65roadster/lab-supply/Design-Doc.xlsx

Buck/Boost Stage Efficiency
efficiency | 90%
Fsw | 500000 |  |  |  |  |  |  |  | Efficiency vs Vout |  |  |  |  |  |  |  |  |  |  |  |  | Max Iout vs Vout |  |  |  |  |  |  |  |  |  |  |  |  |  | Max Iout vs Vout, limited to 0.5A |  |  |  |  |  |  |  |  |  |  |  |  |  | Max Iout vs Vout, no LDO
L | 2.2e-05 |  |  |  |  |  |  |  | Vout | Vin,linear | Vin | Iout,linear | Iout,bb | Iin,bb | Pin | Pout,bb | Pout,linear | Pdiss,linear | Pdiss,bb | Total Pdiss | Total Eff | Vout | Vin,linear | Vin | Iout,linear | Iout,bb | Iin,bb | Pin | Pout,bb | Pout,linear | Pdiss,linear | Pdiss,bb | Total Pdiss | Total Eff | Pload | Vout | Vin,linear | Vin | Iout,linear | Iout,bb | Iin,bb | Pin | Pout,bb | Pout,linear | Pdiss,linear | Pdiss,bb | Total Pdiss | Total Eff | Pload | Vout | Vin,linear | Vin | Iout,bb
 |  |  |  |  |  |  |  |  | 0 | 1.5 | 5 | 0.5 | 0.5 | 0.17 | 0.8333333333 | 0.75 | 0 | 0.75 | 0.08333333333 | 0.8333333333 | 0% | 0 | 1.5 | 5 | 3 | 3 | 1.00 | 5 | 4.5 | 0 | 4.5 | 0.5 | 5 | 0% | 0 | 0 | 1.5 | 5 | 1.5 | 1.5 | 1.00 | 5 | 2.25 | 0 | 2.25 | 0.25 | 2.5 | 0% | 0 | 0.001 | 0.001 | 5 | 1.5
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
