65roadster/lab-supply/lab-supply-control-board.kicad_pcb

## KiCad design lab-supply-control-board.kicad_pcb (2020-06-25)

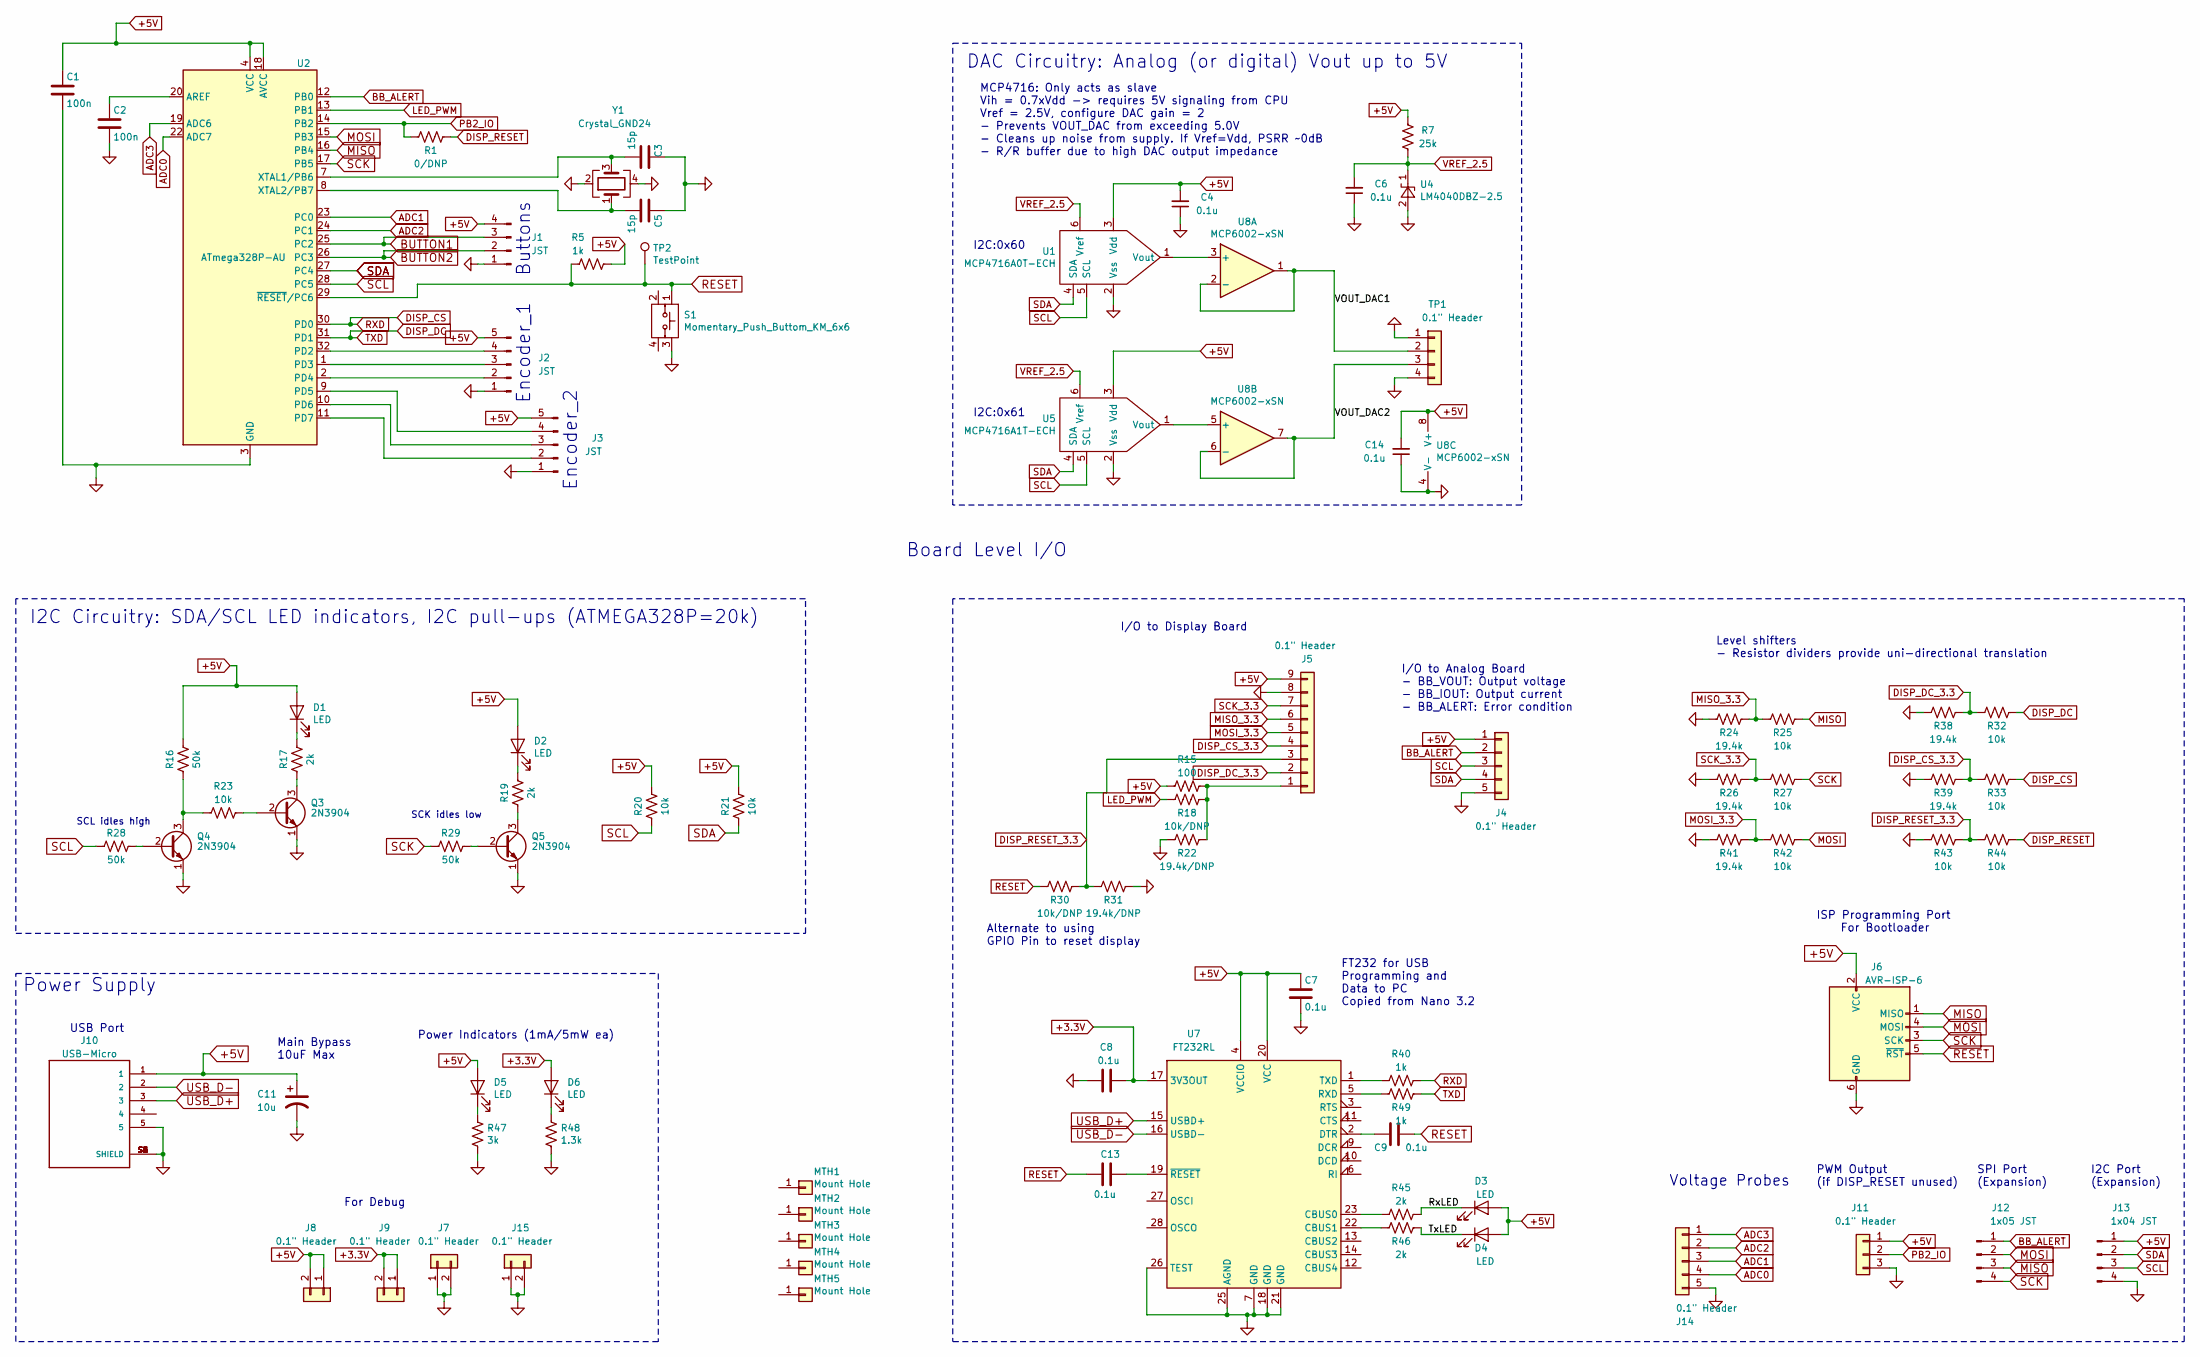
[picture p3: schematic lab-supply-control-board.sch]

Parts:
C1, C2: 100n; C_0805_HandSoldering
C3, C5: 15p; C_0603_HandSoldering
C4, C6, C7, C8, C9, C13, C14: 0.1u; C_0805_HandSoldering
C11: 10u; CP_Elec_4x4.5
D1, D2, D3, D4, D5, D6: LED; LED_0805_2012Metric_Pad1.15x1.40mm_HandSolder
J1: JST; JST_XH_B4B-XH-A_1x04_P2.50mm_Vertical
J2, J3: JST; JST_XH_B5B-XH-A_1x05_P2.50mm_Vertical
J4, J14: 0.1\" Header; JST_XH_B5B-XH-A_1x05_P2.50mm_Vertical
J5: 0.1\" Header; JST_XH_B9B-XH-A_1x09_P2.50mm_Vertical
J6: AVR-ISP-6; AVR-ISP-6-TH
J7, J8, J9, J15: 0.1\" Header; PinHeader_1x02_P2.54mm_Vertical
J10: USB-Micro; USB-Micro-AMPHENOL_10118194-0001LF
J11: 0.1\" Header; PinHeader_1x03_P2.54mm_Vertical
J12: 1x05 JST; JST_XH_B4B-XH-A_1x04_P2.50mm_Vertical
J13: 1x04 JST; JST_XH_B4B-XH-A_1x04_P2.50mm_Vertical
MTH1, MTH2, MTH3, MTH4, MTH5: Mount Hole; Mount-Hole-#6
Q3, Q4, Q5: 2N3904; 2N3904-SOT-23
R1: 0/DNP; R_0805_HandSoldering
R5, R40, R49: 1k; R_0805_HandSoldering
R7: 25k; R_0805_HandSoldering
R15: 100; R_0805_HandSoldering
R16, R28, R29: 50k; R_0805_HandSoldering
R17, R19, R45, R46: 2k; R_0805_HandSoldering
R18, R30: 10k/DNP; R_0805_HandSoldering
R20, R21, R23, R25, R27, R32, R33, R42, R43, R44: 10k; R_0805_HandSoldering
R22, R31: 19.4k/DNP; R_0805_HandSoldering
R24, R26, R38, R39, R41: 19.4k; R_0805_HandSoldering
R47: 3k; R_0805_HandSoldering
R48: 1.3k; R_0805_HandSoldering
S1: Momentary_Push_Buttom_KM_6x6; Momentary_Push_Button_KM_6x6
TP1: 0.1\" Header; JST_XH_B4B-XH-A_1x04_P2.50mm_Vertical
TP2: TestPoint; PinHeader_1x01_P2.54mm_Vertical
U1: MCP4716A0T-ECH; SOT-23-6_Handsoldering
U2: ATmega328P-AU; TQFP-32_7x7mm_P0.8mm
U4: LM4040DBZ-2.5; SOT-23
U5: MCP4716A1T-ECH; SOT-23-6_Handsoldering
U7: FT232RL; SSOP-28_5.3x10.2mm_P0.65mm
U8: MCP6002-xSN; SOP-8_3.9x4.9mm_P1.27mm
Y1: Crystal_GND24; Crystal_SMD_CX2016DB_2.0x1.6mm

Connections:
+3.3V: C8.2, D6.2 (A), J9.1, J9.2, U7.17 (3V3OUT)
+5V: C1.1, C4.2, C7.1, C11.1, C14.2, D1.2 (A), D2.2 (A), D3.2 (A), D4.2 (A), D5.2 (A), J1.4, J2.5, J3.5, J4.1, J5.9, J6.2 (VCC), J8.1, J8.2, J10.1, J11.1, J13.1, R5.2, R7.2, R15.1, R16.1, R20.2, R21.2, U1.3 (Vdd), U2.4 (VCC), U2.6 (VCC), U2.18 (AVCC), U5.3 (Vdd), U7.4 (VCCIO), U7.20 (VCC), U8.8 (V+)
/RxLED: D3.1 (K), R45.1
/TxLED: D4.1 (K), R46.1
/VOUT_DAC1: TP1.2, U8.1, U8.2 (-)
/VOUT_DAC2: TP1.3, U8.6 (-), U8.7
ADC0: J14.4, U2.22 (ADC7)
ADC1: J14.3, U2.23 (PC0)
ADC2: J14.2, U2.24 (PC1)
ADC3: J14.1, U2.19 (ADC6)
BB_ALERT: J4.2, J12.1, U2.12 (PB0)
BUTTON1: J1.3, U2.25 (PC2)
BUTTON2: J1.2, U2.26 (PC3)
DISP_CS: R33.2, R40.1, U2.30 (PD0)
DISP_CS_3.3: J5.4, R33.1, R39.2
DISP_DC: R32.2, R49.1, U2.31 (PD1)
DISP_DC_3.3: J5.2, R32.1, R38.2
DISP_RESET: R1.2, R44.2
DISP_RESET_3.3: J5.3, R30.2, R31.1, R43.2, R44.1
GND: C1.2, C2.2, C3.1, C4.1, C5.1, C6.1, C7.2, C8.1, C11.2, C14.1, J1.1, J2.1, J3.1, J4.5, J5.8, J6.6 (GND), J7.1, J7.2, J10.5, J10.S1 (SHIELD), J10.S2 (SHIELD), J10.S3 (SHIELD), J10.S4 (SHIELD), J10.S5 (SHIELD), J10.S6 (SHIELD), J11.3, J13.4, J14.5, J15.1, J15.2, Q3.1 (E), Q4.1 (E), Q5.1 (E), R22.1, R24.1, R26.1, R31.2, R38.1, R39.1, R41.1, R43.1, R47.2, R48.2, S1.3, TP1.1, TP1.4, U1.2 (Vss), U2.3 (GND), U2.5 (GND), U2.21 (GND), U4.2 (A), U5.2 (Vss), U7.7 (GND), U7.18 (GND), U7.21 (GND), U7.25 (AGND), U7.26 (TEST), U8.4 (V-), Y1.2, Y1.4
LED_PWM: R18.1, U2.13 (PB1)
MISO: J6.1 (MISO), J12.3, R25.2, U2.16 (PB4)
MISO_3.3: J5.6, R24.2, R25.1
MOSI: J6.4 (MOSI), J12.2, R42.2, U2.15 (PB3)
MOSI_3.3: J5.5, R41.2, R42.1
unnamed: C2.1, U2.20 (AREF)
unnamed: C3.2, U2.7 (XTAL1/PB6), Y1.3
unnamed: C5.2, U2.8 (XTAL2/PB7), Y1.1
unnamed: C9.1, U7.2 (DTR)
unnamed: C13.1, U7.19 (~RESET~)
unnamed: D1.1 (K), R17.2
unnamed: D2.1 (K), R19.2
unnamed: D5.1 (K), R47.1
unnamed: D6.1 (K), R48.1
unnamed: J2.2, U2.2 (PD4)
unnamed: J2.3, U2.1 (PD3)
unnamed: J2.4, U2.32 (PD2)
unnamed: J3.2, U2.11 (PD7)
unnamed: J3.3, U2.10 (PD6)
unnamed: J3.4, U2.9 (PD5)
unnamed: J5.1, R15.2, R18.2, R22.2
unnamed: Q3.2 (B), R23.2
unnamed: Q3.3 (C), R17.1
unnamed: Q4.2 (B), R28.2
unnamed: Q4.3 (C), R16.2, R23.1
unnamed: Q5.2 (B), R29.2
unnamed: Q5.3 (C), R19.1
unnamed: R40.2, U7.1 (TXD)
unnamed: R45.2, U7.23 (CBUS0)
unnamed: R46.2, U7.22 (CBUS1)
unnamed: R49.2, U7.5 (RXD)
unnamed: U1.1 (Vout), U8.3 (+)
unnamed: U5.1 (Vout), U8.5 (+)
PB2_IO: J11.2, R1.1, U2.14 (PB2)
RESET: C9.2, C13.2, J6.5 (~RST), R5.1, R30.1, S1.1, TP2.1, U2.29 (~RESET~/PC6)
SCK: J6.3 (SCK), J12.4, R27.2, R29.1, U2.17 (PB5)
SCK_3.3: J5.7, R26.2, R27.1
SCL: J4.3, J13.3, R20.1, R28.1, U1.5 (SCL), U2.28 (PC5), U5.5 (SCL)
SDA: J4.4, J13.2, R21.1, U1.4 (SDA), U2.27 (PC4), U5.4 (SDA)
USB_D+: J10.3, U7.15 (USBD+)
USB_D-: J10.2, U7.16 (USBD-)
VREF_2.5: C6.2, R7.1, U1.6 (Vref), U4.1 (K), U5.6 (Vref)

Notes on the sheet:
Voltage Probes
Encoder_1
Encoder_2
SCL idles high
SCK idles low
ISP Programming Port For Bootloader
DAC Circuitry: Analog (or digital) Vout up to 5V
SPI Port (Expansion)
I2C Circuitry: SDA/SCL LED indicators, I2C pull-ups (ATMEGA328P=20k)
USB Port
Board Level I/O
I2C Port (Expansion)
I/O to Display Board
MCP4716: Only acts as slave Vih = 0.7xVdd -> requires 5V signaling from CPU Vref = 2.5V, configure DAC gain = 2 - Prevents VOUT_DAC from exceeding 5.0V - Cleans up noise from supply. If Vref=Vdd, PSRR ~~0dB - R/R buffer due to high DAC output impedance
Power Indicators (1mA/5mW ea)
For Debug
PWM Output (if DISP_RESET unused)
I/O to Analog Board - BB_VOUT: Output voltage - BB_IOUT: Output current - BB_ALERT: Error condition
Level shifters - Resistor dividers provide uni-directional translation
Power Supply
Alternate to using GPIO Pin to reset display
Main Bypass 10uF Max
FT232 for USB Programming and Data to PC Copied from Nano 3.2
I2C:0x60
I2C:0x61
Buttons

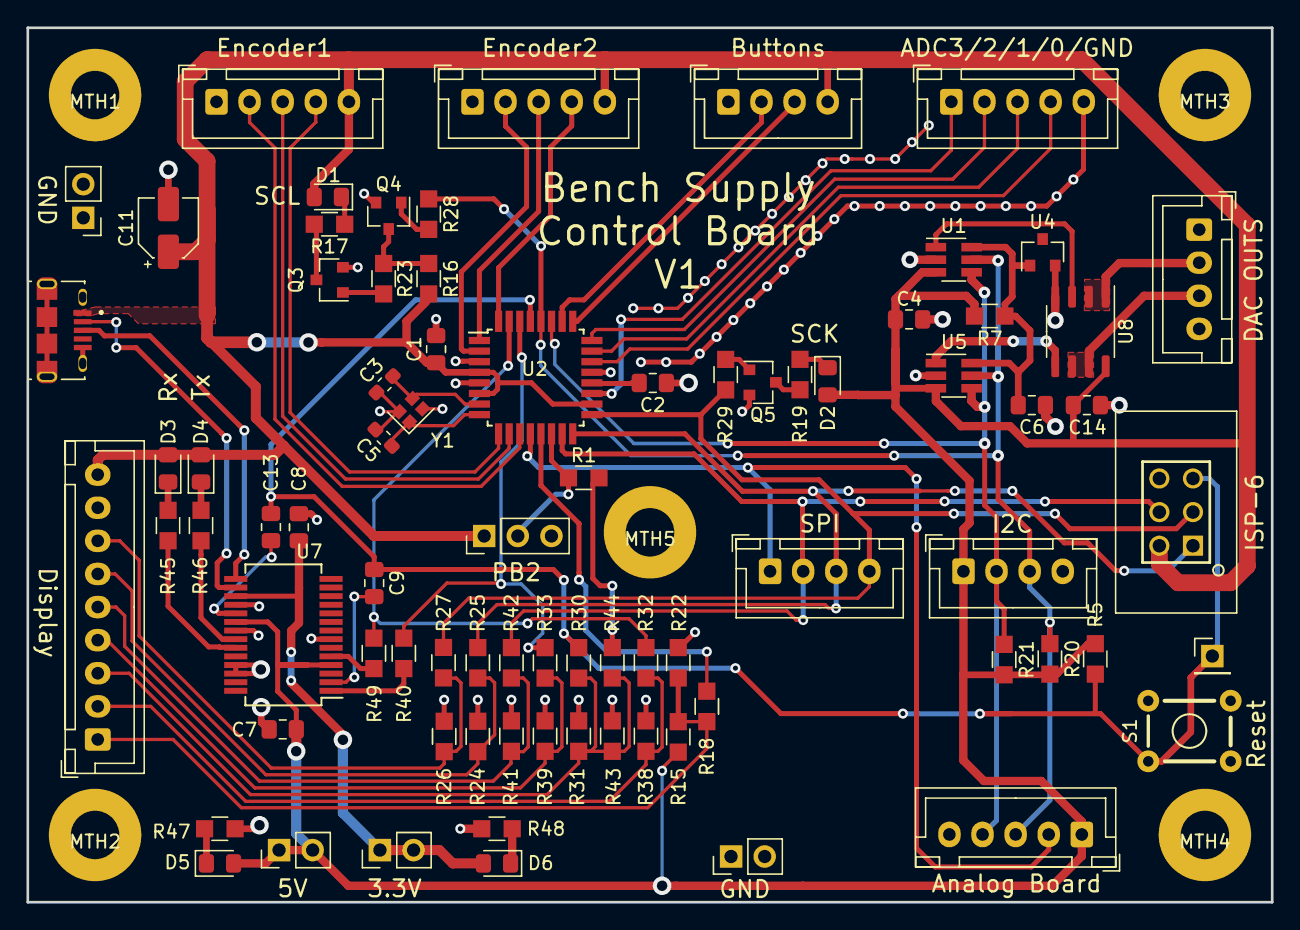
[picture p4: board lab-supply-control-board.kicad_pcb from above]

Board: 2 copper layers, 94.0 x 66.0 mm, 85 parts (0 on the bottom side), 62 nets.
