65roadster/lab-supply/lab-supply-split-rail.kicad_pcb

## KiCad design lab-supply-split-rail.kicad_pcb (2020-06-10)

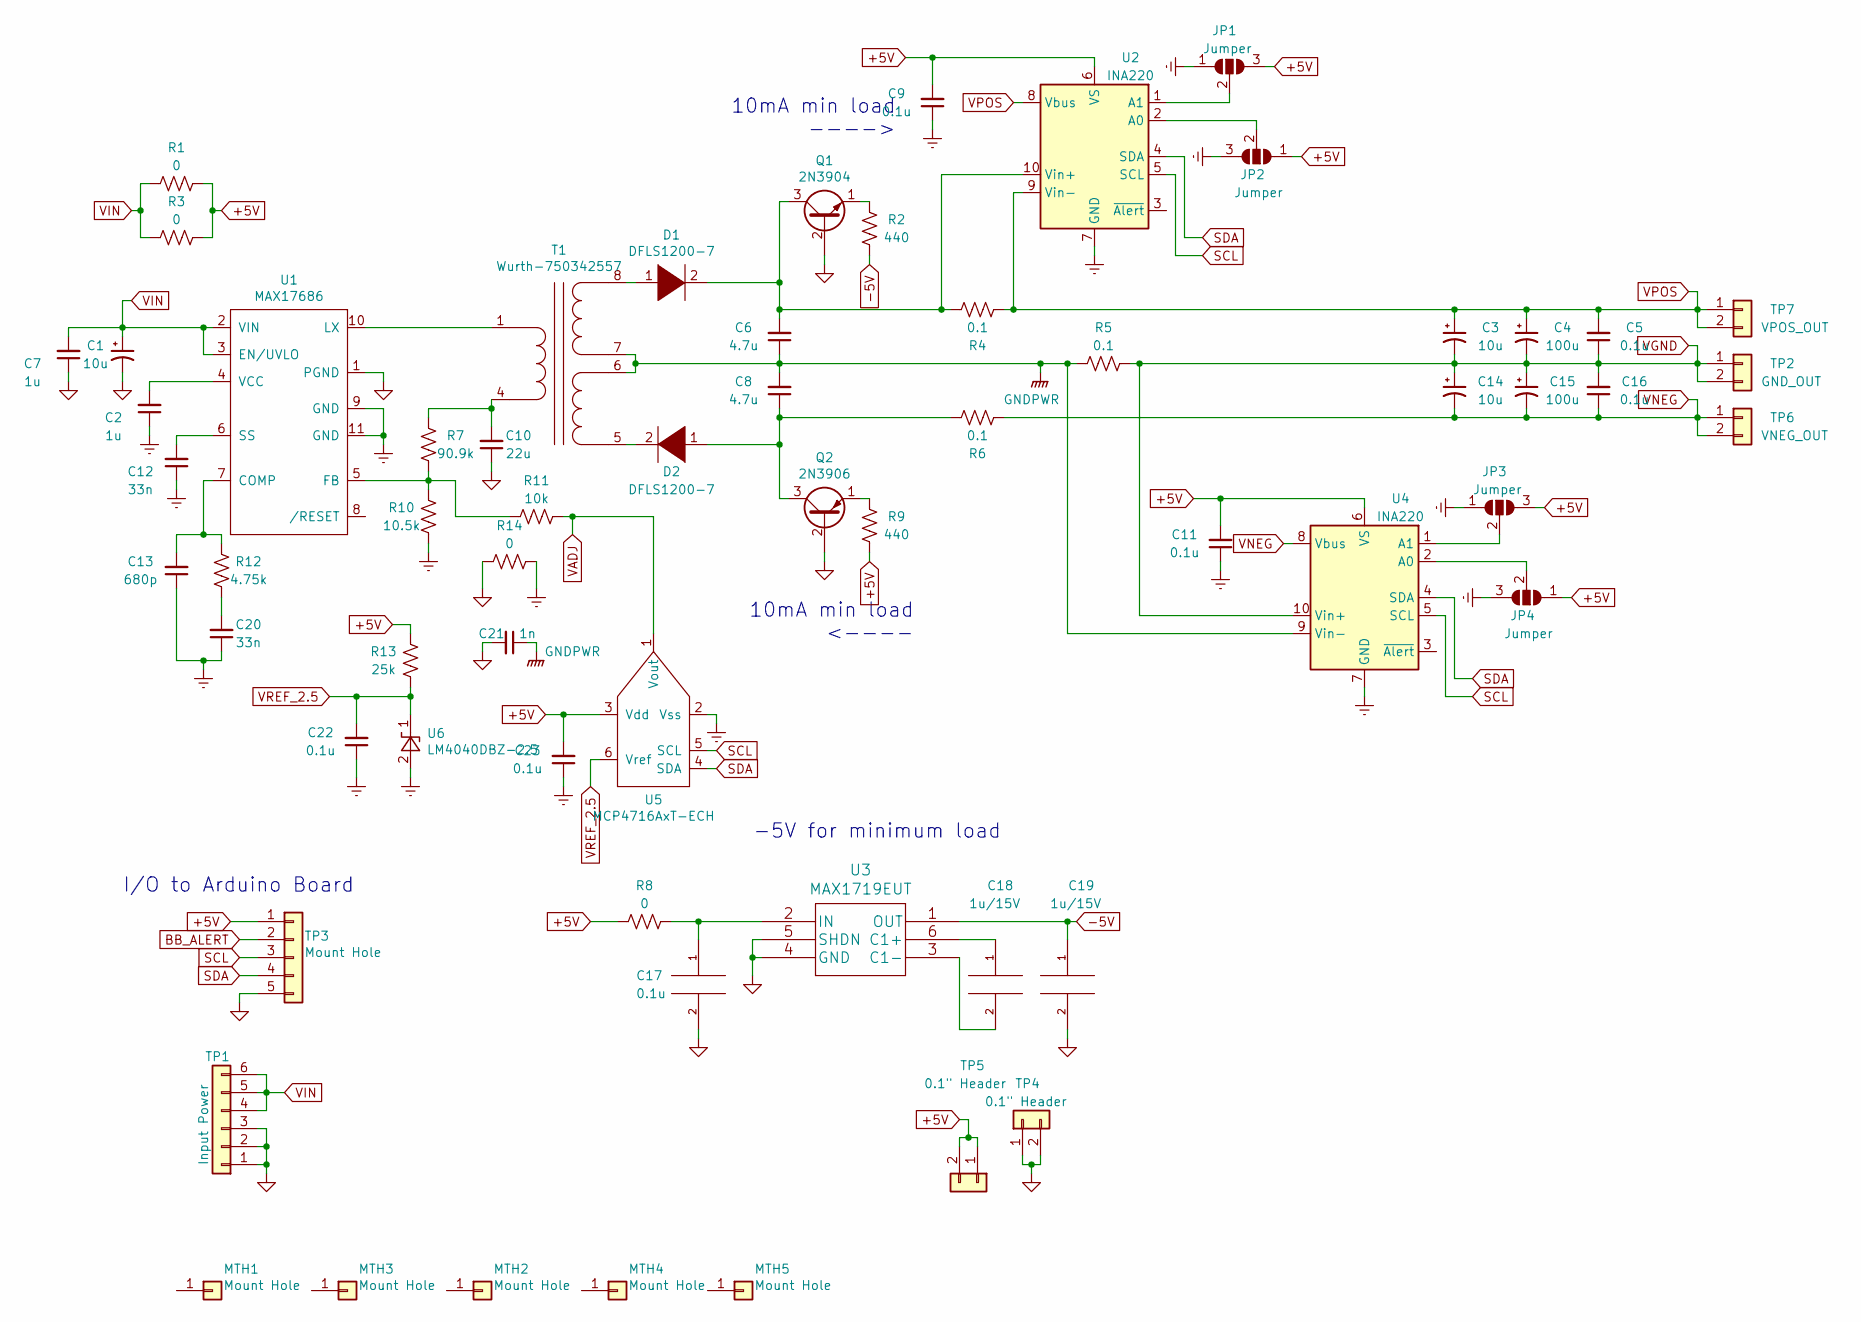
[picture p5: schematic lab-supply-split-rail.sch]

Parts:
C1, C3, C14: 10u; CP_Elec_4x4.5
C2, C7: 1u; C_0603_HandSoldering
C4, C15: 100u; CP_Elec_6.3x5.9
C5, C9, C11, C16, C22, C23: 0.1u; C_0603_HandSoldering
C6, C8: 4.7u; C_0603_HandSoldering
C10: 22u; C_0603_HandSoldering
C12, C20: 33n; C_0603_HandSoldering
C13: 680p; C_0603_HandSoldering
C17: 0.1u; C_0805_HandSoldering
C18, C19: 1u/15V; C_0805_HandSoldering
C21: 1n; C_0603_HandSoldering
D1, D2: DFLS1200-7; D_PowerDI-123
JP1, JP2, JP3, JP4: Jumper; SolderJumper_3_Pad
MTH1, MTH2, MTH3, MTH4, MTH5: Mount Hole; Mount-Hole-#6
Q1: 2N3904; SOT-23
Q2: 2N3906; SOT-23
R1, R3, R8, R14: 0; R_0805_HandSoldering
R2, R9: 440; R_0805_HandSoldering
R4, R5, R6: 0.1; R_2512_HandSoldering
R7: 90.9k; R_0805_HandSoldering
R10: 10.5k; R_0805_HandSoldering
R11: 10k; R_0805_HandSoldering
R12: 4.75k; R_0805_HandSoldering
R13: 25k; R_0805_HandSoldering
T1: Wurth-750342557
TP1: Input Power; PinHeader_1x06_P2.54mm_Vertical
TP2: GND_OUT; PinHeader_1x02_P2.54mm_Vertical
TP3: Mount Hole; JST_XH_B5B-XH-A_1x05_P2.50mm_Vertical
TP4, TP5: 0.1\" Header; PinHeader_1x02_P2.54mm_Vertical
TP6: VNEG_OUT; PinHeader_1x02_P2.54mm_Vertical
TP7: VPOS_OUT; PinHeader_1x02_P2.54mm_Vertical
U1: MAX17686; DFN-10-1EP_2x3mm_P0.5mm_EP0.64x2.4mm
U2, U4: INA220; VSSOP-10_3x3mm_P0.5mm
U3: MAX1719EUT; TSOT-23-6_HandSoldering
U5: MCP4716AxT-ECH; SOT-23-6_Handsoldering
U6: LM4040DBZ-2.5; SOT-23

Connections:
+5V: C9.2, C11.2, C23.2, JP1.3 (B), JP2.1 (A), JP3.3 (B), JP4.1 (A), R1.2, R3.2, R8.2, R9.1, R13.2, TP3.1, TP5.1, TP5.2, U2.6 (VS), U4.6 (VS), U5.3 (Vdd)
-5V: C19.1, R2.1, U3.1 (OUT)
Earth: C2.1, C9.1, C11.1, C12.1, C13.1, C20.1, C22.1, C23.1, JP1.1 (A), JP2.3 (B), JP3.1 (A), JP4.3 (B), R10.1, R14.2, U1.9 (GND), U1.11 (GND), U2.7 (GND), U4.7 (GND), U5.2 (Vss), U6.2 (A)
GND: C1.2, C7.1, C10.1, C17.2, C19.2, C21.2, Q1.2 (B), Q2.2 (B), R14.1, TP1.1, TP1.2, TP1.3, TP3.5, TP4.1, TP4.2, U1.1 (PGND), U3.4 (GND), U3.5 (SHDN)
GNDPWR: C6.1, C8.2, C21.1, R5.2, T1.6, T1.7, U4.9 (Vin-)
unnamed: C2.2, U1.4 (VCC)
unnamed: C6.2, D1.2 (A), Q1.3 (C), R4.2, U2.10 (Vin+)
unnamed: C8.1, D2.1 (K), Q2.3 (C), R6.2
unnamed: C10.2, R7.2, T1.4
unnamed: C12.2, U1.6 (SS)
unnamed: C13.2, R12.2, U1.7 (COMP)
unnamed: C17.1, R8.1, U3.2 (IN)
unnamed: C18.1, U3.6 (C1+)
unnamed: C18.2, U3.3 (C1-)
unnamed: C20.2, R12.1
unnamed: D1.1 (K), T1.8
unnamed: D2.2 (A), T1.5
unnamed: JP1.2 (C), U2.1 (A1)
unnamed: JP2.2 (C), U2.2 (A0)
unnamed: JP3.2 (C), U4.1 (A1)
unnamed: JP4.2 (C), U4.2 (A0)
unnamed: Q1.1 (E), R2.2
unnamed: Q2.1 (E), R9.2
unnamed: R7.1, R10.2, R11.1, U1.5 (FB)
unnamed: T1.1, U1.10 (LX)
SCL: TP3.3, U2.5 (SCL), U4.5 (SCL), U5.5 (SCL)
SDA: TP3.4, U2.4 (SDA), U4.4 (SDA), U5.4 (SDA)
VADJ: R11.2, U5.1 (Vout)
VGND: C3.2, C4.2, C5.1, C14.1, C15.1, C16.2, R5.1, TP2.1, TP2.2, U4.10 (Vin+)
VIN: C1.1, C7.2, R1.1, R3.1, TP1.4, TP1.5, TP1.6, U1.2 (VIN), U1.3 (EN/UVLO)
VNEG: C14.2, C15.2, C16.1, R6.1, TP6.1, TP6.2, U4.8 (Vbus)
VPOS: C3.1, C4.1, C5.2, R4.1, TP7.1, TP7.2, U2.8 (Vbus), U2.9 (Vin-)
VREF_2.5: C22.2, R13.1, U5.6 (Vref), U6.1 (K)

Notes on the sheet:
-5V for minimum load
10mA min load ---->
I/O to Arduino Board
10mA min load <----

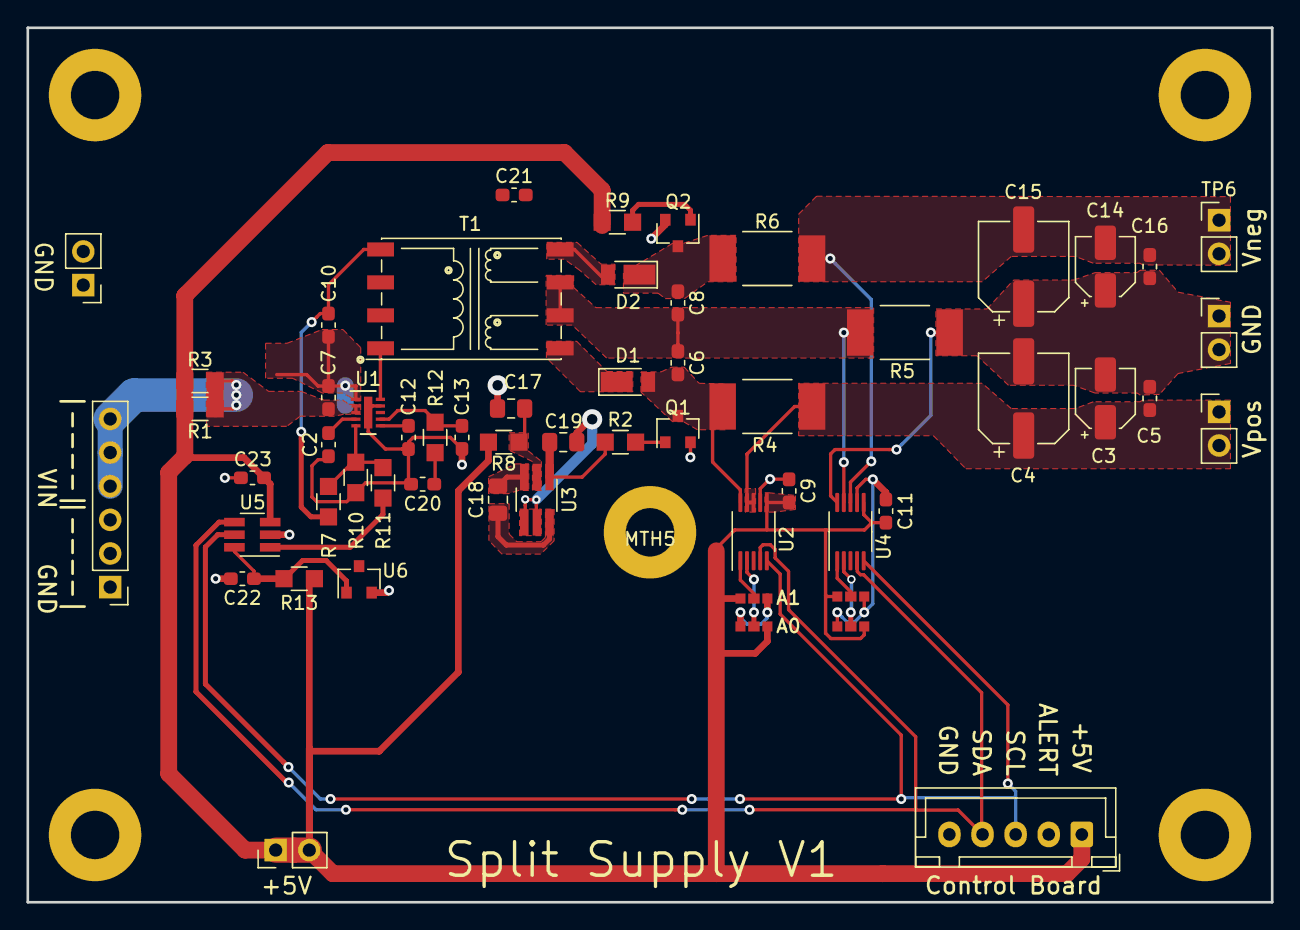
[picture p6: board lab-supply-split-rail.kicad_pcb from above]

Board: 2 copper layers, 94.0 x 66.0 mm, 63 parts (1 on the bottom side), 33 nets.
