65roadster/lab-supply/lab-supply-usb-buck-boost.kicad_pcb

## KiCad design lab-supply-usb-buck-boost.kicad_pcb (2020-06-10)

Schematic: lab-supply-usb-buck-boost.sch

Parts:
C1, C14: 10u; CP_Elec_4x4.5
C2, C3, C4, C5, C7, C9, C16: 0.1u; C_0603_HandSoldering
C6: 22nF; C_0603_HandSoldering
C8, C10, C11, C12, C13: 22u; C_1210_HandSoldering
C15: 100u; CP_Elec_6.3x5.9
C17: 0.1u; C_0805_HandSoldering
C18, C19: 1u/15V; C_0805_HandSoldering
JP1, JP2: Jumper; SolderJumper_3_Pad
L1: 100uH; L_Bourns_SRR1260
MTH1, MTH2, MTH3, MTH4, MTH5: Mount Hole; Mount-Hole-#6
Q1: Q_NPN_BCE; SOT-23
R1, R2, R3, R6, R9: DNP; R_0805_HandSoldering
R4: 21.5k; R_0805_HandSoldering
R5: 0.1; R_2512_HandSoldering
R7, R8, R10, R11: 0; R_0805_HandSoldering
TP1: Input Power; PinHeader_1x06_P2.54mm_Vertical
TP2: GND Debug; PinHeader_1x02_P2.54mm_Vertical
TP3: Mount Hole; JST_XH_B5B-XH-A_1x05_P2.50mm_Vertical
TP4, TP5: 0.1\" Header; PinHeader_1x02_P2.54mm_Vertical
TP6: Output Power; PinHeader_1x02_P2.54mm_Vertical
TP7: Power Debug; PinHeader_1x02_P2.54mm_Vertical
U1: MP8862GQ
U2: INA220; VSSOP-10_3x3mm_P0.5mm
U3: MAX1719EUT; TSOT-23-6_HandSoldering

Connections:
+5V: C9.2, JP1.1 (A), JP2.1 (A), R3.1, R8.2, R10.1, R11.1, TP3.1, TP5.1, TP5.2, U2.6 (VS)
-5V: C19.1, R9.2, U3.1 (OUT)
BB_ALERT: R3.2, TP3.2, U1.8
BB_EN: R1.1, U1.3
GND: C1.2, C2.1, C5.1, C6.1, C7.1, C8.2, C9.1, C10.1, C11.2, C12.1, C13.2, C14.2, C15.2, C16.1, C17.2, C19.2, JP1.3 (B), JP2.3 (B), Q1.1, R4.1, R6.2, TP1.1, TP1.2, TP1.3, TP2.2, TP3.5, TP4.1, TP4.2, TP6.1, TP6.2, U1.2, U1.10, U1.11, U2.7 (GND), U3.4 (GND), U3.5 (SHDN)
unnamed: C3.1, U1.16
unnamed: C3.2, L1.1, U1.15
unnamed: C4.1, L1.2, U1.14
unnamed: C4.2, U1.13
unnamed: C5.2, R1.2, R2.2, U1.9
unnamed: C6.2, R4.2, U1.7
unnamed: C7.2, C8.1, R5.2, U1.12, U2.9 (Vin-)
unnamed: C17.1, R8.1, U3.2 (IN)
unnamed: C18.1, U3.6 (C1+)
unnamed: C18.2, U3.3 (C1-)
unnamed: JP1.2 (C), U2.1 (A1)
unnamed: JP2.2 (C), U2.2 (A0)
unnamed: Q1.2, R9.1
unnamed: R2.1, R6.1, U1.4
unnamed: R5.1, R7.2, U2.10 (Vin+)
SCL: TP3.3, U1.5, U2.5 (SCL)
SDA: TP3.4, U1.6, U2.4 (SDA)
VCC_BB: C1.1, C2.2, R10.2, R11.2, TP1.4, TP1.5, TP1.6, U1.1
VOUT: C10.2, C11.1, C12.2, C13.1, C14.1, C15.1, C16.2, Q1.3, R7.1, TP2.1, TP7.1, TP7.2, U2.8 (Vbus)

Notes on the sheet:
-5V for minimum load
<---- 5mA min load
I/O to Arduino Board
I2C: ADD=GND, 0x69 ADD=Vcc, 0x6F
Allow to run off Vin other than 5V from control board

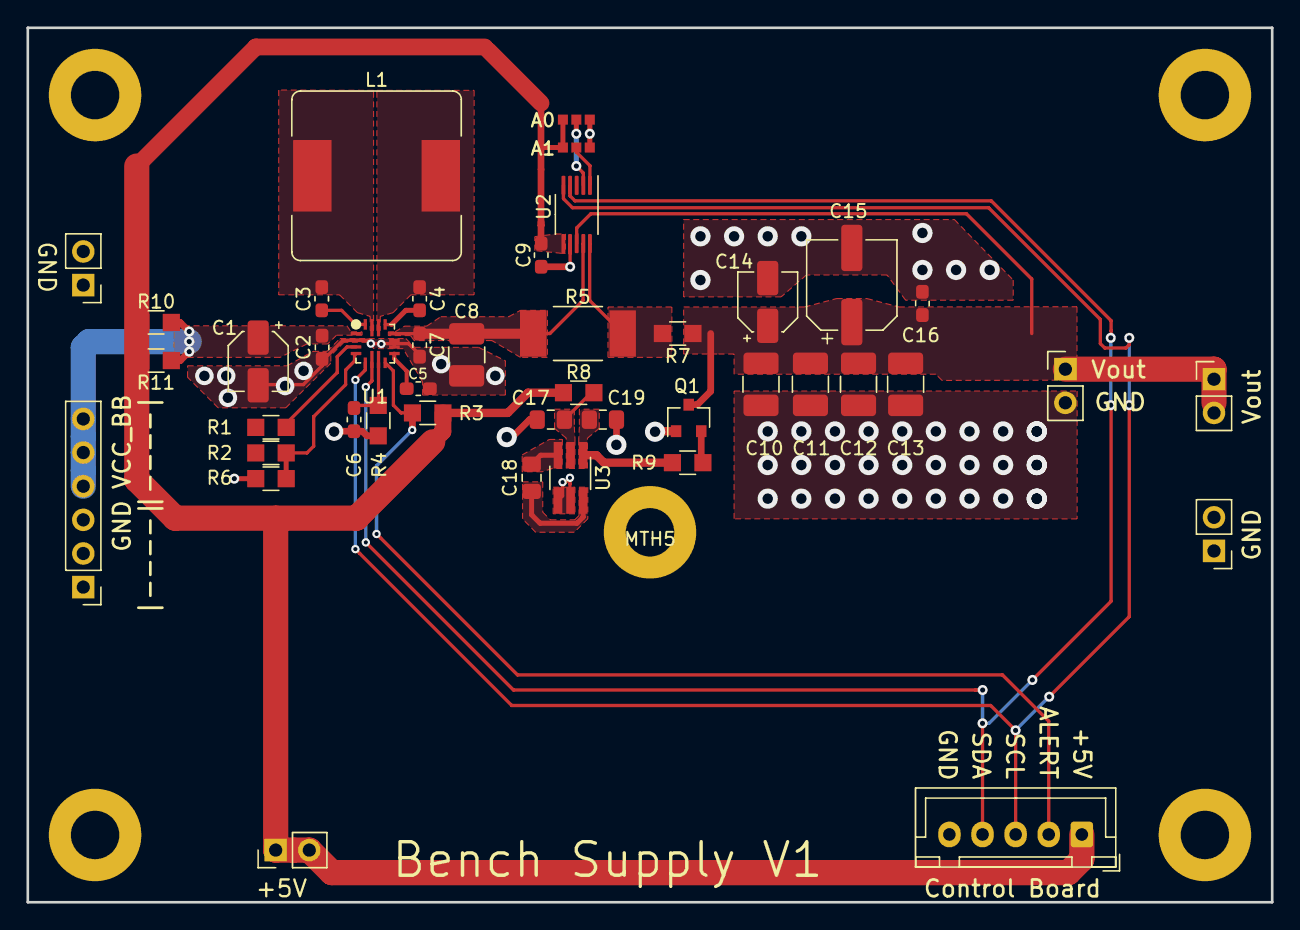
[picture p7: board lab-supply-usb-buck-boost.kicad_pcb from above]

Board: 2 copper layers, 94.0 x 66.0 mm, 49 parts (0 on the bottom side), 24 nets.
