65roadster/lab-supply/lab-supply-usb-buck.kicad_pcb

## KiCad design lab-supply-usb-buck.kicad_pcb (2020-06-10)

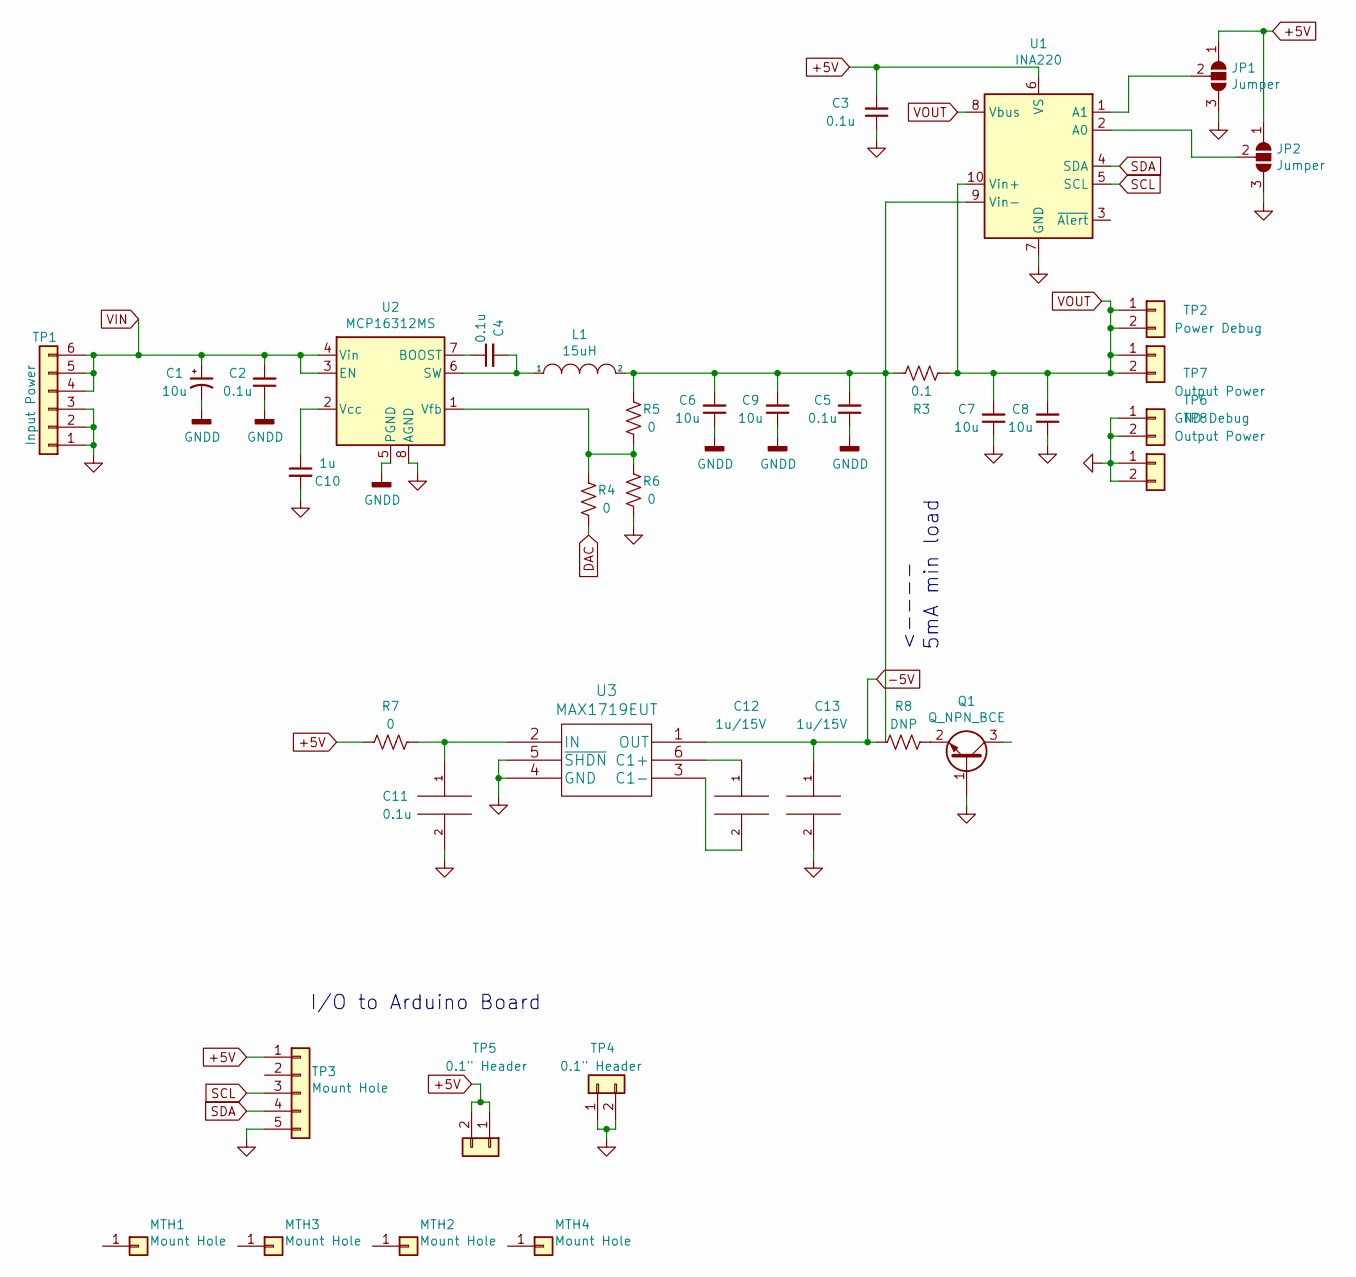
[picture p8: schematic lab-supply-usb-buck.sch]

Parts:
C1, C6, C7, C8, C9: 10u; C_1210_HandSoldering
C2, C4, C11: 0.1u; C_0805_HandSoldering
C3, C5: 0.1u; C_0603_HandSoldering
C10: 1u; C_0805_HandSoldering
C12, C13: 1u/15V; C_0805_HandSoldering
JP1, JP2: Jumper; SolderJumper_3_Pad
L1: 15uH; Coilcraft-XGL6060
MTH1, MTH2, MTH3, MTH4: Mount Hole; Mount-Hole-#6
Q1: Q_NPN_BCE; SOT-23
R3: 0.1; R_2512_HandSoldering
R4, R5, R6, R7: 0; R_0805_HandSoldering
R8: DNP; R_0805_HandSoldering
TP1: Input Power; PinHeader_1x06_P2.54mm_Vertical
TP2: Power Debug; PinHeader_1x02_P2.54mm_Vertical
TP3: Mount Hole; JST_XH_B5B-XH-A_1x05_P2.50mm_Vertical
TP4, TP5: 0.1\" Header; PinHeader_1x02_P2.54mm_Vertical
TP6: GND Debug; PinHeader_1x02_P2.54mm_Vertical
TP7, TP8: Output Power; PinHeader_1x02_P2.54mm_Vertical
U1: INA220; VSSOP-10_3x3mm_P0.5mm
U2: MCP16312MS; MSOP-8_3x3mm_P0.65mm
U3: MAX1719EUT; TSOT-23-6_HandSoldering

Connections:
+5V: C3.2, JP1.1 (A), JP2.1 (A), R7.2, TP3.1, TP5.1, TP5.2, U1.6 (VS)
-5V: C13.1, R8.2, U3.1 (OUT)
GND: C3.1, C7.1, C8.1, C10.2, C11.2, C13.2, JP1.3 (B), JP2.3 (B), Q1.1 (B), R6.1, TP1.1, TP1.2, TP1.3, TP3.5, TP4.1, TP4.2, TP7.1, TP7.2, TP8.1, TP8.2, U1.7 (GND), U2.8 (AGND), U3.4 (GND), U3.5 (~SHDN)
GNDD: C1.2, C2.1, C5.1, C6.1, C9.1, U2.5 (PGND)
unnamed: C4.1, U2.7 (BOOST)
unnamed: C4.2, L1.1, U2.6 (SW)
unnamed: C5.2, C6.2, C9.2, L1.2, R3.2, R5.2, U1.9 (Vin-)
unnamed: C10.1, U2.2 (Vcc)
unnamed: C11.1, R7.1, U3.2 (IN)
unnamed: C12.1, U3.6 (C1+)
unnamed: C12.2, U3.3 (C1-)
unnamed: JP1.2 (C), U1.1 (A1)
unnamed: JP2.2 (C), U1.2 (A0)
unnamed: Q1.2 (E), R8.1
unnamed: R4.2, R5.1, R6.2, U2.1 (Vfb)
SCL: TP3.3, U1.5 (SCL)
SDA: TP3.4, U1.4 (SDA)
VIN: C1.1, C2.2, TP1.4, TP1.5, TP1.6, U2.3 (EN), U2.4 (Vin)
VOUT: C7.2, C8.2, R3.1, TP2.1, TP2.2, TP6.1, TP6.2, U1.8 (Vbus), U1.10 (Vin+)

Notes on the sheet:
I/O to Arduino Board
<---- 5mA min load

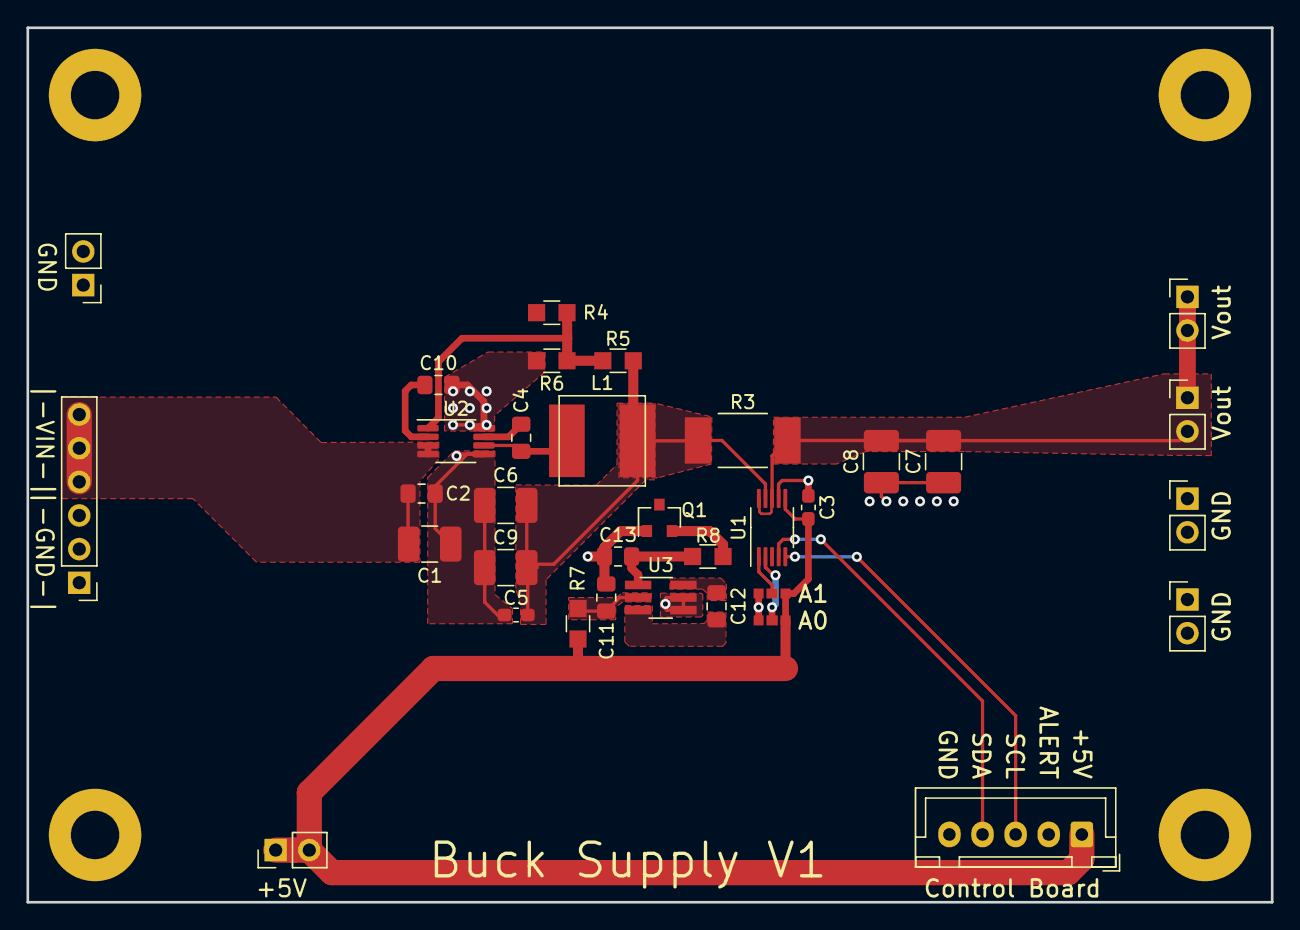
[picture p9: board lab-supply-usb-buck.kicad_pcb from above]

Board: 2 copper layers, 94.0 x 66.0 mm, 38 parts (0 on the bottom side), 19 nets.
