65roadster/lab-supply/lab-supply-usb-boost-buck.kicad_pcb

## KiCad design lab-supply-usb-boost-buck.kicad_pcb (2020-06-10)

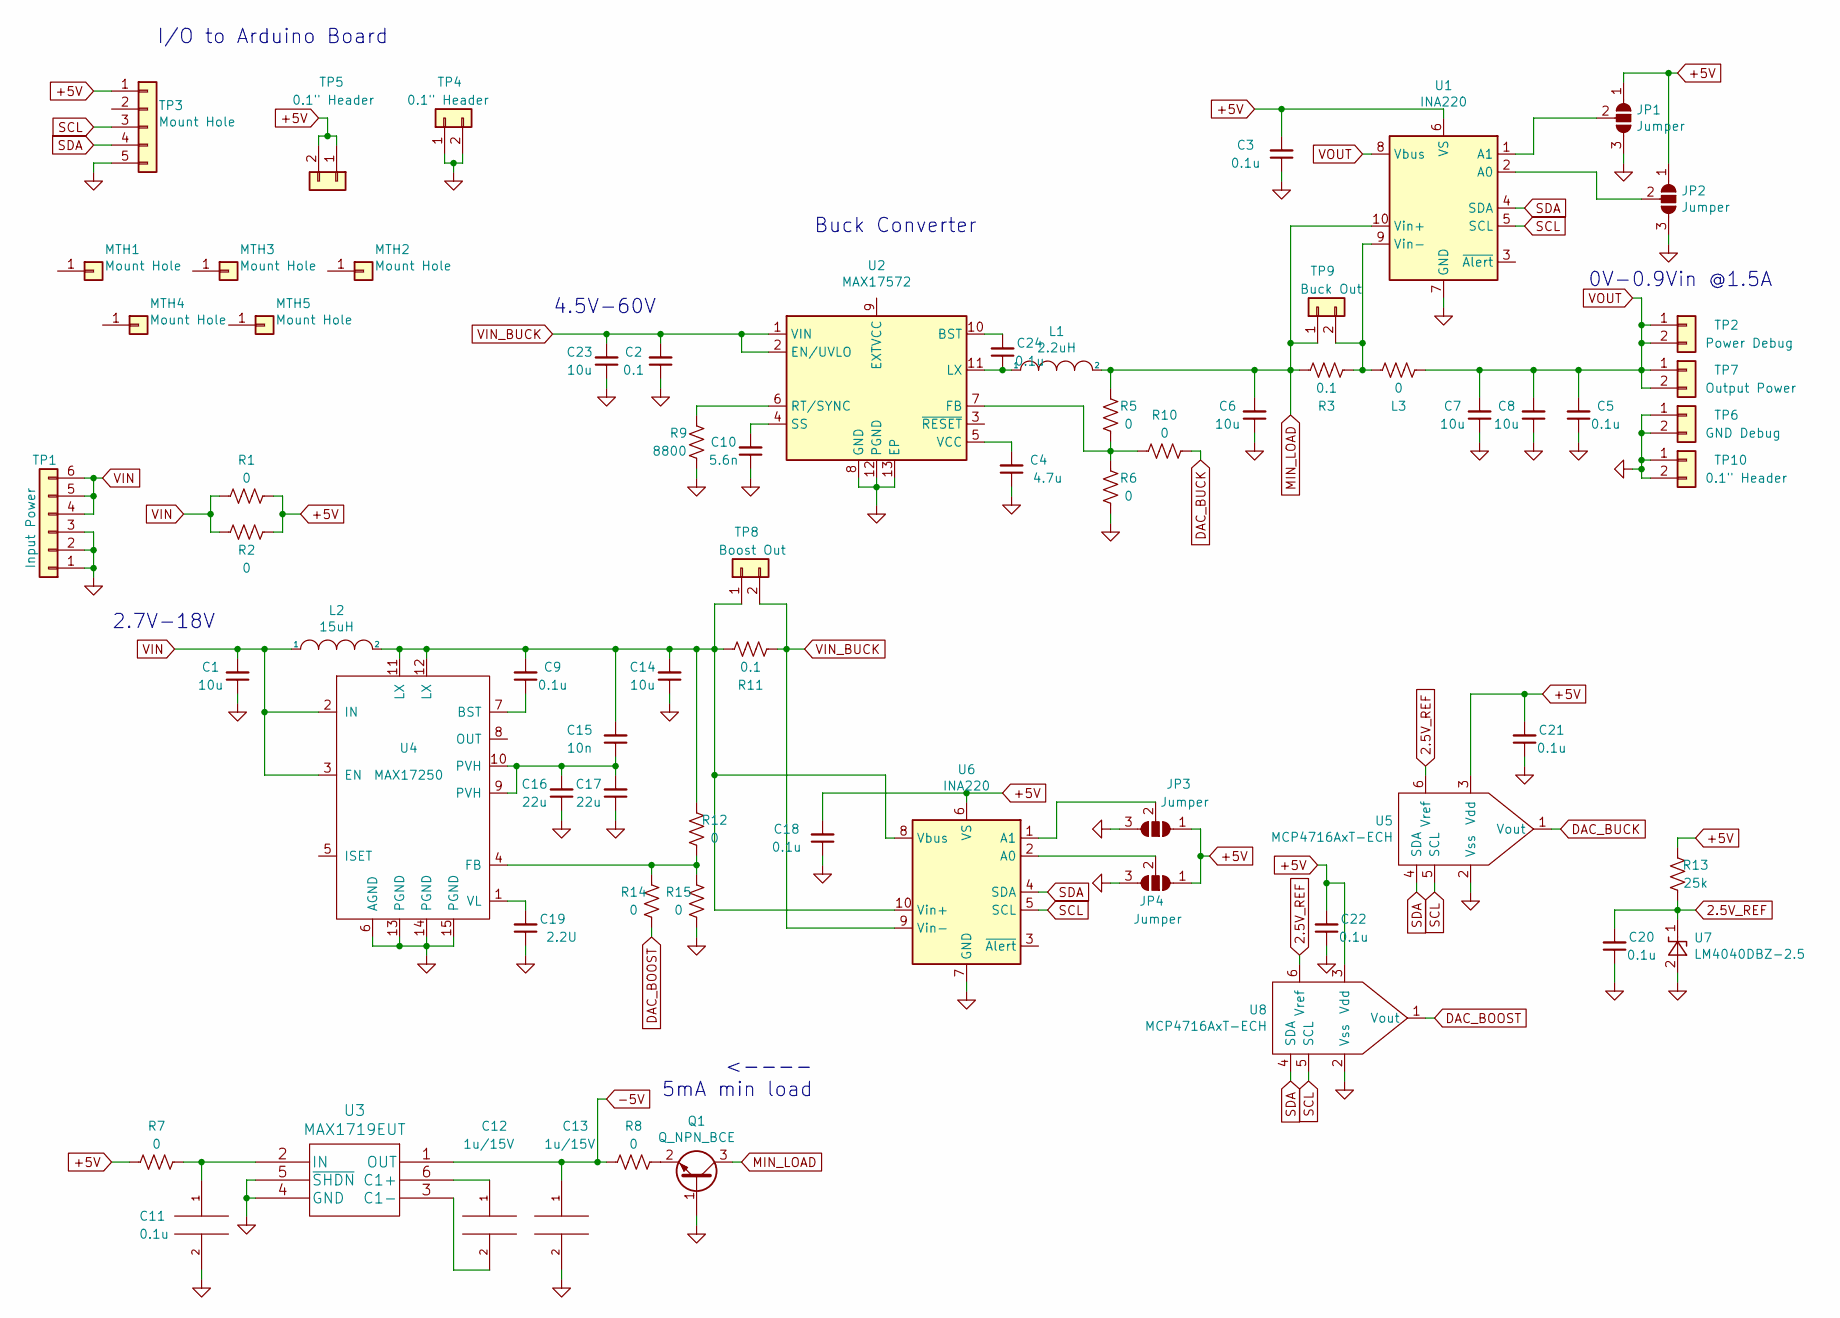
[picture p10: schematic lab-supply-usb-boost-buck.sch]

Parts:
C1, C6, C7, C8, C14, C23: 10u; C_1210_HandSoldering
C2: 0.1; C_0805_HandSoldering
C3, C5, C9, C11, C18, C20, C21, C22, C24: 0.1u; C_0805_HandSoldering
C4: 4.7u; C_0805_HandSoldering
C10: 5.6n; C_0805_HandSoldering
C12, C13: 1u/15V; C_0805_HandSoldering
C15: 10n; C_0603_HandSoldering
C16, C17: 22u; C_1210_HandSoldering
C19: 2.2U; C_0805_HandSoldering
JP1, JP2, JP3, JP4: Jumper; SolderJumper_3_Pad
L1: 2.2uH; Coilcraft-XFL4020
L2: 15uH; Coilcraft-XAL4040
L3: 0; R_0805_HandSoldering
MTH1, MTH2, MTH3, MTH4, MTH5: Mount Hole; Mount-Hole-#6
Q1: Q_NPN_BCE; SOT-23
R1, R2, R5, R6, R7, R8, R10, R12, R14, R15: 0; R_0805_HandSoldering
R3, R11: 0.1; R_2512_HandSoldering
R9: 8800; R_0805_HandSoldering
R13: 25k; R_0805_HandSoldering
TP1: Input Power; PinHeader_1x06_P2.54mm_Vertical
TP2: Power Debug; PinHeader_1x02_P2.54mm_Vertical
TP3: Mount Hole; JST_XH_B5B-XH-A_1x05_P2.50mm_Vertical
TP4, TP5, TP10: 0.1\" Header; PinHeader_1x02_P2.54mm_Vertical
TP6: GND Debug; PinHeader_1x02_P2.54mm_Vertical
TP7: Output Power; PinHeader_1x02_P2.54mm_Vertical
TP8: Boost Out; PinHeader_1x02_P2.54mm_Vertical
TP9: Buck Out; PinHeader_1x02_P2.54mm_Vertical
U1, U6: INA220; VSSOP-10_3x3mm_P0.5mm
U2: MAX17572; DFN-12-1EP_3x3mm_P0.5mm_EP2.05x2.86mm
U3: MAX1719EUT; TSOT-23-6_HandSoldering
U4: MAX17250; DFN-14-1EP_3x3mm_P0.4mm_EP1.78x2.35mm-6mil-DRC
U5, U8: MCP4716AxT-ECH; SOT-23-6_Handsoldering
U7: LM4040DBZ-2.5; SOT-23

Connections:
2.5V_REF: C20.2, R13.1, U5.6 (Vref), U7.1 (K), U8.6 (Vref)
+5V: C3.2, C18.2, C21.2, C22.2, JP1.1 (A), JP2.1 (A), JP3.1 (A), JP4.1 (A), R1.1, R2.1, R7.2, R13.2, TP3.1, TP5.1, TP5.2, U1.6 (VS), U5.3 (Vdd), U6.6 (VS), U8.3 (Vdd)
-5V: C13.1, R8.2, U3.1 (OUT)
DAC_BOOST: R14.2, U8.1 (Vout)
DAC_BUCK: R10.2, U5.1 (Vout)
GND: C1.1, C2.1, C3.1, C4.1, C5.1, C6.1, C7.1, C8.1, C10.1, C11.2, C13.2, C14.1, C16.1, C17.1, C18.1, C19.1, C20.1, C21.1, C22.1, C23.1, JP1.3 (B), JP2.3 (B), JP3.3 (B), JP4.3 (B), Q1.1 (B), R6.1, R9.1, R15.1, TP1.1, TP1.2, TP1.3, TP3.5, TP4.1, TP4.2, TP7.1, TP7.2, TP10.1, TP10.2, U1.7 (GND), U2.8 (GND), U2.12 (PGND), U2.13 (EP), U3.4 (GND), U3.5 (~SHDN), U4.6 (AGND), U4.13 (PGND), U4.14 (PGND), U4.15 (PGND), U5.2 (Vss), U6.7 (GND), U7.2 (A), U8.2 (Vss)
MIN_LOAD: C6.2, L1.2, Q1.3 (C), R3.2, R5.2, TP9.1, U1.10 (Vin+)
unnamed: C4.2, U2.5 (VCC)
unnamed: C9.1, U4.7 (BST)
unnamed: C10.2, U2.4 (SS)
unnamed: C11.1, R7.1, U3.2 (IN)
unnamed: C12.1, U3.6 (C1+)
unnamed: C12.2, U3.3 (C1-)
unnamed: C9.2, C14.2, C15.2, L2.2, R11.2, R12.2, TP8.1, U4.11 (LX), U4.12 (LX), U6.8 (Vbus), U6.10 (Vin+)
unnamed: C15.1, C16.2, C17.2, U4.9 (PVH), U4.10 (PVH)
unnamed: C19.2, U4.1 (VL)
unnamed: C24.1, L1.1, U2.11 (LX)
unnamed: C24.2, U2.10 (BST)
unnamed: JP1.2 (C), U1.1 (A1)
unnamed: JP2.2 (C), U1.2 (A0)
unnamed: JP3.2 (C), U6.1 (A1)
unnamed: JP4.2 (C), U6.2 (A0)
unnamed: L3.2, R3.1, TP9.2, U1.9 (Vin-)
unnamed: Q1.2 (E), R8.1
unnamed: R9.2, U2.6 (RT/SYNC)
unnamed: R5.1, R6.2, R10.1, U2.7 (FB)
unnamed: R12.1, R14.1, R15.2, U4.4 (FB)
SCL: TP3.3, U1.5 (SCL), U5.5 (SCL), U6.5 (SCL), U8.5 (SCL)
SDA: TP3.4, U1.4 (SDA), U5.4 (SDA), U6.4 (SDA), U8.4 (SDA)
VIN: C1.2, L2.1, R1.2, R2.2, TP1.4, TP1.5, TP1.6, U4.2 (IN), U4.3 (EN)
VIN_BUCK: C2.2, C23.2, R11.1, TP8.2, U2.1 (VIN), U2.2 (EN/UVLO), U6.9 (Vin-)
VOUT: C5.2, C7.2, C8.2, L3.1, TP2.1, TP2.2, TP6.1, TP6.2, U1.8 (Vbus)

Notes on the sheet:
I/O to Arduino Board
<---- 5mA min load
4.5V-60V
Buck Converter
0V-0.9Vin @1.5A
2.7V-18V

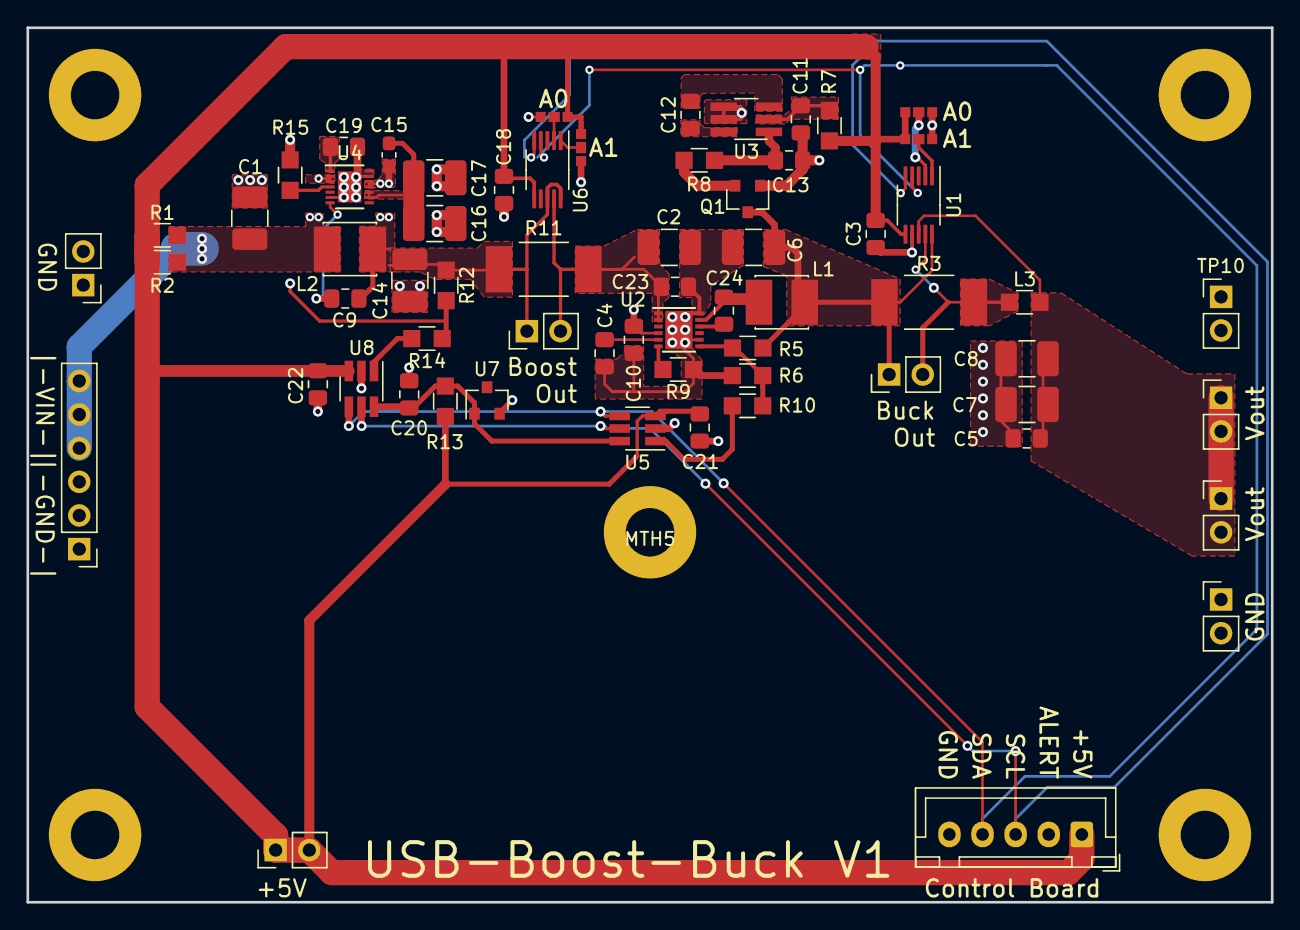
[picture p11: board lab-supply-usb-boost-buck.kicad_pcb from above]

Board: 2 copper layers, 94.0 x 66.0 mm, 69 parts (0 on the bottom side), 32 nets.
