65roadster/lab-supply/(commit log)

2020-05-27 Kept working on the design
    [lab-supply.kicad_pcb, lab-supply.sch]
2020-05-28 Updated Control Board
    [lab-supply-control-board.sch]
2020-05-28 Added PB0/1 IO Port
    [lab-supply-control-board.sch]
2020-05-28 Added FT232
    [lab-supply-control-board.sch, lab-supply.kicad_pcb]
2020-05-30 Worked over the schematic, started layout
    [lab-supply-control-board-xmega.sch, lab-supply-control-board.kicad_pcb, lab-supply-control-board.sch]
2020-05-30 schematic tweak
    [lab-supply-control-board.kicad_pcb, lab-supply-control-board.sch]
2020-05-31 Updates to schematic, started control board layout
    [lab-supply-control-board.kicad_pcb, lab-supply-control-board.sch]
2020-06-02 Updated control sch, first full cut at layout
    [lab-supply-control-board.kicad_pcb, lab-supply-control-board.sch, lab-supply.sch]
2020-06-03 Worked on board layouts
    [lab-supply-control-board.kicad_pcb, lab-supply-control-board.sch, lab-supply.sch]
2020-06-04 More work on board layouts
    [lab-supply-control-board.kicad_pcb, lab-supply.kicad_pcb, lab-supply.sch]
2020-06-05 Separated Vcc_bb from 5V
    Allows for buck/boost to run off of separate Vin from the rest of the circuit. For example +12V
    [lab-supply.kicad_pcb, lab-supply.sch]
2020-06-10 Lots of updates
    [Design-Doc.xlsx, lab-supply-control-board.kicad_pcb, lab-supply-split-rail.kicad_pcb, lab-supply-split-rail.sch, lab-supply-usb-boost-buck.kicad_pcb, lab-supply-usb-boost-buck.sch, lab-supply-usb-buck-boost.kicad_pcb, lab-supply-usb-buck-boost.sch]
2020-06-10 more work
    [lab-supply-control-board-xmega.sch]
2020-06-11 Next to final edits on control board
2020-06-25 finalized before PCB orders
    [lab-supply-control-board-xmega.sch, lab-supply-control-board.kicad_pcb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]
